hari4579/temp_BMS/README.md

# Distributed Battery Temperature Monitoring System

A modular, CAN-based temperature monitoring system developed for a **7.2 kWh, 40S12P battery pack**. The system uses distributed STM32-based temperature acquisition boards to monitor multiple locations across the battery pack and communicate temperature data to a central Battery Management System (BMS).

The architecture supports **75 NTC temperature-sensing channels**, combining five distributed monitoring boards with 13 channels each and 10 additional temperature-sensing points.

---

## 1. Project Overview

Battery temperature monitoring is essential for identifying thermal abnormalities and improving battery pack safety. This project implements a distributed temperature acquisition architecture to monitor temperatures across a high-capacity battery pack.

Instead of routing every thermistor signal to a single controller, temperature measurements are acquired locally by distributed microcontroller-based boards. Each board processes its NTC inputs, calculates temperature, performs fault checks, and transmits the acquired data over a CAN network.

### System Specifications

| Parameter | Specification |
|---|---|
| Battery pack energy | 7.2 kWh |
| Battery configuration | 40S12P |
| Total cell positions | 480 |
| Temperature-monitoring boards | 5 |
| NTC channels per board | 13 |
| Channels across five boards | 65 |
| Additional NTC sensors | 10 |
| **Total temperature-sensing channels** | **75** |
| Communication protocol | CAN |
| CAN bit rate | 500 kbps |
| Microcontroller | STM32F407VET6 |
| Temperature sensor | 10 kΩ NTC |

The 75 sensing points provide distributed temperature monitoring across the battery pack. The system does not assume one thermistor per cell.

## 2. System Architecture

The system follows a distributed temperature acquisition architecture.

Each temperature-monitoring board independently:
1. Acquires 13 NTC thermistor signals.
2. Converts ADC readings into thermistor resistance.
3. Calculates temperature using the Beta equation.
4. Checks for overtemperature and sensor faults.
5. Transmits temperature telemetry through CAN.

The distributed boards communicate with the central BMS controller over a shared CAN network.

### Architecture Diagram

```text
              7.2 kWh Battery Pack
                    40S12P
                       |
           Distributed NTC Sensors
                       |
       +---------------+---------------+
       |               |               |
       v               v               v
 +-----------+   +-----------+   +-----------+
 | Board 1   |   | Board 2   |   | Board 3   |
 | STM32     |   | STM32     |   | STM32     |
 | 13 NTC    |   | 13 NTC    |   | 13 NTC    |
 +-----------+   +-----------+   +-----------+
       |               |               |
       +---------------+---------------+
                       |
                 CAN Bus
                 500 kbps
                       |
       +---------------+---------------+
       |                               |
       v                               v
 +-----------+                   +-----------+
 | Board 4   |                   | Board 5   |
 | STM32     |                   | STM32     |
 | 13 NTC    |                   | 13 NTC    |
 +-----------+                   +-----------+
       |                               |
       +---------------+---------------+
                       |
                 CAN Network
                       |
                       v
             +------------------+
             | BMS Master       |
             | APARD32690       |
             +------------------+
                       |
                       v
              Battery Monitoring

       Additional temperature sensing:
                  10 NTC points

       Total system capacity: 75 channels
```

## 3. Hardware Design

### 3.1 Microcontroller – STM32F407VET6

Each temperature-monitoring board uses the STM32F407VET6 microcontroller.

Key features:
- ARM Cortex-M4 processor.
- 32-bit processing architecture.
- 12-bit ADC.
- Multiple communication peripherals.
- DMA support for ADC acquisition.
- SWD interface for programming and debugging.

The microcontroller handles thermistor acquisition, temperature conversion, fault detection, and CAN communication.

### 3.2 Temperature Sensing Circuit

The system uses MF55-series 10 kΩ NTC thermistors.

Each thermistor is connected through a voltage-divider circuit using a 10 kΩ reference resistor.

| Parameter | Value |
|---|---|
| Thermistor type | NTC |
| Thermistor resistance at 25°C | 10 kΩ |
| Reference resistor | 10 kΩ |
| Reference voltage | 3.3 V |
| ADC resolution | 12-bit |
| ADC channels per board | 13 |
| Number of boards | 5 |
| Additional sensors | 10 |
| Total sensing channels | 75 |

The analog voltage generated by each voltage divider is sampled by the STM32 ADC.

### 3.3 Temperature Calculation

The firmware converts ADC readings into resistance values and calculates temperature using the Beta equation.

\[
T=\left(\frac{1}{T_0}+\frac{1}{B}\ln\left(\frac{R}{R_0}\right)\right)^{-1}
\]

Where:

- \(T\) = Temperature in Kelvin.
- \(T_0\) = Reference temperature (298.15 K).
- \(B\) = Thermistor Beta coefficient (3950).
- \(R\) = Calculated thermistor resistance.
- \(R_0\) = Thermistor resistance at reference temperature (10 kΩ).

The calculated temperature is converted into Celsius for telemetry transmission.

### 3.4 Power Supply

The board receives a 5 V supply and uses a TLV75733 low-dropout regulator to generate the 3.3 V supply required by the microcontroller and associated circuitry.

### 3.5 CAN Communication

The TJA1051 CAN transceiver provides the physical interface between the STM32 and the CAN bus.

| Parameter | Configuration |
|---|---|
| CAN transceiver | TJA1051 |
| Communication protocol | CAN |
| Bit rate | 500 kbps |
| MCU logic supply | 3.3 V |
| Transceiver supply | 5 V |
| Termination | 120 Ω provision |

The distributed boards transmit temperature measurements to the central BMS controller through the shared CAN network.

---

## 4. PCB Design

The project includes two PCB revisions developed during the hardware design process.

### 4.1 V1 – Proof of Concept



The first PCB revision was developed to establish the hardware architecture and evaluate the initial circuit implementation.

Key design elements:
- STM32F407VET6-based temperature acquisition circuit.
- NTC voltage-divider interfaces.
- 5 V to 3.3 V power regulation.
- CAN transceiver circuitry.
- Test points for hardware measurements and debugging.

### 4.2 V2 – Revised PCB


The second revision represents the subsequent PCB design iteration.

It retains the distributed temperature acquisition architecture and incorporates updates made after the initial proof of concept.

The design integrates:
- STM32F407VET6 microcontroller.
- NTC sensing interfaces.
- Power regulation circuitry.
- CAN communication interface.
- Programming and debugging access.

### 4.3 Four-Layer PCB Stack-Up

The PCB uses a four-layer stack-up to organize signal routing, grounding, and power distribution.

| Layer | Function |
|---|---|
| L1 – Top | Component placement and signal routing |
| L2 – Inner 1 | Ground plane |
| L3 – Inner 2 | Power distribution |
| L4 – Bottom | Signal routing |

The dedicated ground and power layers provide reference planes and help organize routing for the mixed-signal design.

### 4.4 PCB Design Considerations

- Separation of analog temperature-sensing signals and digital circuitry.
- Ground-plane continuity and return-current paths.
- Power distribution for the MCU and CAN transceiver.
- SWD programming and debugging access.
- CAN bus routing and termination provisions.
- Test points for hardware bring-up and debugging.

---

## 5. Firmware Architecture

The firmware is developed using the STM32 Hardware Abstraction Layer (HAL).

The main firmware functions include:

1. ADC initialization and configuration.
2. DMA-based acquisition of 13 NTC channels.
3. ADC data buffering.
4. Conversion of ADC readings into thermistor resistance.
5. Temperature calculation using the Beta equation.
6. Overtemperature and sensor fault detection.
7. CAN telemetry generation and transmission.

### 5.1 ADC Acquisition

The STM32 ADC is configured for 13-channel scanning with DMA.

DMA transfers acquired ADC samples into a memory buffer, reducing the need for continuous CPU polling.

The firmware uses separate buffers to maintain and process acquired temperature data.

### 5.2 Fault Detection

The firmware includes checks for:

- Overtemperature conditions.
- NTC short-circuit conditions.
- NTC open-circuit conditions.

Overtemperature detection uses separate trip and clear thresholds, along with debounce logic, to avoid unnecessary fault triggering due to small measurement fluctuations.

The firmware defines fault codes for reporting the detected condition.

### 5.3 Temperature Telemetry

The firmware packs temperature readings into CAN frames.

Each temperature value is represented as a signed 16-bit fixed-point value, with a scaling factor of 100.

For example:

```text
Temperature:       25.50 °C
Transmitted value: 2550
```

The 13 channels are organized into four CAN frames:

| Frame | Temperature Channels | Payload |
|---|---|---|
| Frame 0 | CH0–CH3 | 8 bytes |
| Frame 1 | CH4–CH7 | 8 bytes |
| Frame 2 | CH8–CH11 | 8 bytes |
| Frame 3 | CH12 | 2 bytes |

The CAN identifier is generated using the board ID and frame index:

\[
CAN\ ID = 0x100 + (BOARD\_ID \times 0x10) + Frame
\]

This allows multiple temperature boards to share the same CAN network while maintaining separate message identifiers.

The firmware schedules telemetry transmission at 100 ms intervals.

### 5.4 CAN Fault Reporting

The firmware also defines fault-reporting messages.

Fault information includes:
- Board identification through the CAN arbitration ID.
- Thermistor channel identification.
- Fault type.

| Fault Code | Description |
|---|---|
| 0 | No fault |
| 1 | Overtemperature |
| 2 | Sensor short |
| 3 | Sensor open |

---

## 6. Repository Structure

```text
Temperature-Monitoring-System/
│
├── PCB/
│   ├── V1/
│   │   └── PCB design files
│   │
│   └── V2/
│       └── PCB design files
│
├── Firmware/
│   ├── Core/
│   │   ├── Inc/
│   │   └── Src/
│   │
│   └── STM32 project files
│
├── Documentation/
│   ├── Design_Report.pdf
│   └── Hardware documentation
│
└── README.md
```

*The directory structure is illustrative and should be adjusted to match the actual repository contents.*

---

## 7. Design Objectives

- Distributed acquisition of battery temperature measurements.
- Monitoring of 75 NTC temperature-sensing points.
- Modular hardware architecture.
- Local digitization of analog temperature signals.
- CAN-based communication with the central BMS.
- Scalable temperature monitoring across multiple battery locations.
- Detection of sensor faults and overtemperature conditions.
- Dedicated PCB design for temperature acquisition and communication.

## 8. Future Development

- Integration of all five temperature boards with the BMS master.
- Integration and documentation of the 10 additional temperature-sensing channels.
- Validation of temperature readings against calibrated reference measurements.
- CAN communication testing under multi-node operation.
- Hardware validation of sensor open-circuit and short-circuit detection.
- Integration of temperature fault information into BMS shutdown logic.
- Evaluation of communication reliability and timing under full system load.

## 9. Project Status

The project includes the temperature-monitoring hardware design, two PCB revisions, and STM32 firmware development.

The firmware implements ADC acquisition, NTC temperature conversion, fault detection logic, and CAN telemetry generation.

Full multi-board integration, additional sensor integration, and system-level validation remain development objectives.

## 10. Testing and Demonstration

A testing video demonstrating the temperature-monitoring system and its hardware operation is included below.

### Hardware Testing

The demonstration video showcases the hardware testing process and temperature-monitoring functionality.

**Testing Video:**

[TEMP_PoC.mp4](https://drive.google.com/file/d/1_f34zJ-By_HTeCJ9r7HJWei0OFtLDCeV/view?usp=drive_link)

The video provides a visual demonstration of the prototype during testing.
## Technologies Used

- **Microcontroller:** STM32F407VET6
- **Embedded Development:** Embedded C, STM32 HAL
- **Temperature Sensing:** 10 kΩ NTC thermistors
- **Analog Acquisition:** 12-bit ADC, DMA
- **Communication:** CAN, TJA1051
- **Power Regulation:** TLV75733
- **PCB Design:** Four-layer PCB
- **BMS Platform:** APARD32690, ADBMS6830
