hari4579/temp_BMS/support_final/production/bom_7s.csv

Designator | Footprint | Quantity | Value | LCSC Part #
C1, C4 | 805 | 2 | 2.2uF X7R 0805
C10, C11 | 603 | 2 | 2.2uF X7R 0603
C12 | 603 | 1 | 1uF X7R 0603
C13, C35, C6, C9 | 402 | 4 | 0.1uF X7R 0402
C14, C15, C16, C18, C8 | 603 | 5 | 0.1uF X7R 0603
C2 | 805 | 1 | 1uF X7R 0805
C21, C5, C7 | 603 | 3 | 4.7uF X7R 0603
C3 | 805 | 1 | 22uF X7R 0805
C34 | 603 | 1 | 10uF X7R 0603
D1 | 603 | 1 | LED 0603 BLUE
D2 | diode | 1 | 1N5819WS
D3 | 603 | 1 | LED 0603
F1, F2, F3, F4, F5, F6, F7 | 0453Series_LTF | 7 | 0453.400MR
R1, R10, R11, R12, R13, R17, R2, R3, R4, R5, R6, R7, R8, R9 | 402 | 14 | 10k 0402
R15, R21 | 402 | 2 | 330 ohms 0402
R16 | 603 | 1 | 120 ohms 0603
SW2 | SW_SPST_TS-1088-xR020 | 1 | SW_Push
U1 | SOIC-8_3.9x4.9mm_P1.27mm | 1 | TJA1051T-3
U2 | LQFP-100_14x14mm_P0.5mm | 1 | STM32F446VETx
U4 | SOT-223-3_TabPin2 | 1 | AMS1117-3.3
