hari4579/temp_BMS/support_final/support_final.step

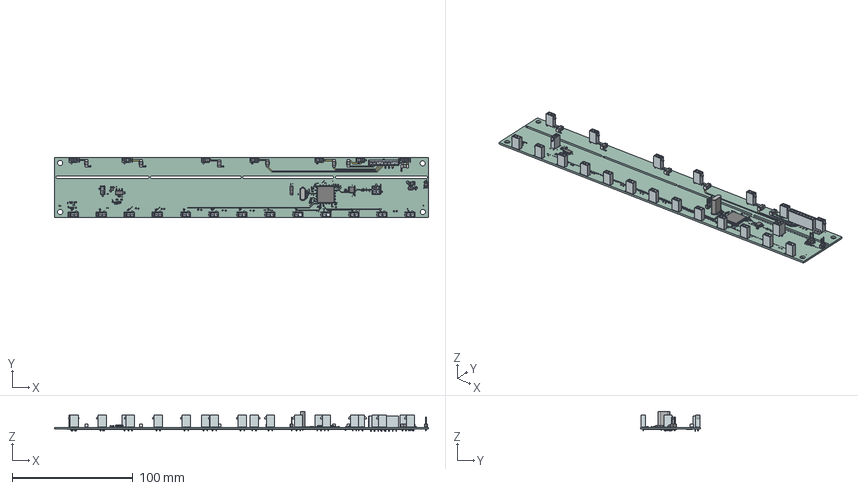
[picture p7: CAD file, 2026-10-30]
support_final/support_final.step
310.0 x 50.0 x 16.7 mm
R_0402_1005Metric x 18
SOIC-8_3.9x4.9mm_P1.27mm
C_0805_2012Metric x 4
C_0603_1608Metric x 12
2165711008wbm000_03
C_0402_1005Metric x 5
LQFP-100_14x14mm_P0.5mm
SOT-223
LED_0603_1608Metric
2068320401wbm000_01
PinHeader_1x02_P254mm_Vertical x 2
Crystal_HC49-U_Vertical
PinHeader_1x03_P254mm_Vertical
SW_SPST_TS-1088-xR020
R_0603_1608Metric
support_final_copper
support_final_via
support_final_silkscreen x 2
support_final_PCB
