hari4579/temp_BMS/support_final/support_final.kicad_pcb

## KiCad design support_final/support_final.kicad_pcb (2026-10-30)

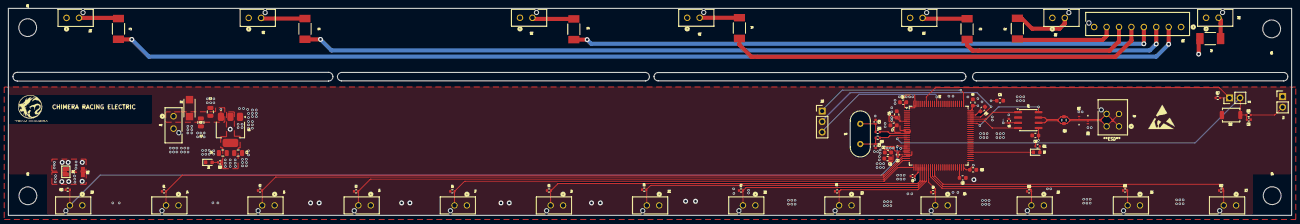
[picture p8: board support_final.kicad_pcb from above]

Board: 4 copper layers, 310.0 x 50.0 mm, 91 parts (1 on the bottom side), 51 nets.

Parts:
C1, C4: 2.2uF X7R 0805; C_0805_2012Metric
C2: 1uF X7R 0805; C_0805_2012Metric
C3: 22uF X7R 0805; C_0805_2012Metric
C5, C7, C21: 4.7uF X7R 0603; C_0603_1608Metric
C6, C9, C13, C35: 0.1uF X7R 0402; C_0402_1005Metric
C8, C14, C15, C16, C18: 0.1uF X7R 0603; C_0603_1608Metric
C10, C11: 2.2uF X7R 0603; C_0603_1608Metric
C12: 1uF X7R 0603; C_0603_1608Metric
C19, C20: 20pF; C_0402_1005Metric
C34: 10uF X7R 0603; C_0603_1608Metric
CR1, CR2: PESD1CANFD36LS-QYL; PESD1
D1: LED 0603 BLUE; LED_0603_1608Metric
D2: 1N5819WS; diode
D3: LED 0603; LED_0603_1608Metric
F1, F2, F3, F4, F5, F6, F7: 0453.400MR; 0453Series_LTF
FB1: 80-120mohm (400mA -600mA) 0603 (BLM18AG121SN1D); BEADC1608X65N
H1, H2, H3, H4: MountingHole; MountingHole_4.3mm_M4
J1, J4, J5, J6, J7, J8, J11, J12, J13, J14, J15, J16, J17, J18, J21, J22, J23, J24, J25, J26, J27: Conn_01x02_Socket; microfit+_2
J2, J3: Conn_01x02_Pin; PinHeader_1x02_P2.54mm_Vertical
J9: Conn_01x04_Pin; CONN_2068320000-SD_04_MOL
J10: Conn_01x03_Socket; PinHeader_1x03_P2.54mm_Vertical
J20: Conn_01x08_Socket; CONN_2165710003-SD_08_MOL
JP1: SolderJumper_2_Open; SolderJumper-2_P1.3mm_Open_Pad1.0x1.5mm
R1, R2, R3, R4, R5, R6, R7, R8, R9, R10, R11, R12, R13, R17, R20: 10k 0402; R_0402_1005Metric
R15, R21: 330 ohms 0402; R_0402_1005Metric
R16: 120 ohms 0603; R_0603_1608Metric
R18: 0 ohms; R_0402_1005Metric
R19: 33 ohms; R_0402_1005Metric
SW2: SW_Push; SW_SPST_TS-1088-xR020
U1: TJA1051T-3; SOIC-8_3.9x4.9mm_P1.27mm
U2: STM32F446VETx; LQFP-100_14x14mm_P0.5mm
U4: AMS1117-3.3; SOT-223-3_TabPin2
Y1: 26MHz(YXC - HC-49US); Crystal_HC49-U_Vertical

Connections:
3.3V: C3.1, C4.1, C7.1, C8.1, C9.1, C14.1, C15.1, C16.1, C18.1, FB1.2, J2.2, JP1.1 (A), R15.1, R20.2, R21.1, U1.5 (VIO), U2.6 (VBAT), U2.11 (VDD), U2.19 (VDD), U2.28 (VDD), U2.50 (VDD), U2.75 (VDD), U2.100 (VDD), U4.2 (VO)
/MCU/BOOT0: J3.1, R17.2, U2.94 (BOOT0)
/MCU/RST: C35.1, J3.2, R20.1, SW2.2, U2.14 (NRST)
/MCU/SWCLK: J10.1, U2.76 (PA14)
/MCU/SWDIO: J10.2, U2.72 (PA13)
/MCU/SWO: J10.3, U2.89 (PB3)
/NTC/C1: F7.2, J20.2
/NTC/C1_f: F7.1, J27.2
/NTC/C2: F6.2, J20.3
/NTC/C2_f: F6.1, J26.2 (Pin_2_2)
/NTC/C3: F5.2, J20.4
/NTC/C3_f: F5.1, J25.2 (Pin_2_2)
/NTC/C4: F4.2, J20.5
/NTC/C4_f: F4.1, J24.2 (Pin_2_2)
/NTC/C5: F3.2, J20.6
/NTC/C5_f: F3.1, J23.2 (Pin_2_2)
/NTC/C6: F2.2, J20.7
/NTC/C6_f: F2.1, J22.2 (Pin_2_2)
/NTC/C7: F1.2, J20.8
/NTC/C7_f: F1.1, J21.2
/NTC/s_ground: J20.1, J21.1, J27.1
A0: J4.2, R1.2, U2.23 (PA0)
A1: J5.2, R2.2, U2.24 (PA1)
A2: J6.2, R3.2, U2.25 (PA2)
A3: J7.2, R4.2, U2.26 (PA3)
A4: J8.2, R5.2, U2.29 (PA4)
A5: J11.2, R6.2, U2.30 (PA5)
A6: J12.2, R7.2, U2.31 (PA6)
A7: J13.2, R8.2, U2.32 (PA7)
A8: J14.2, R9.2, U2.33 (PC4)
A9: J15.2, R10.2, U2.34 (PC5)
A10: J16.2, R11.2, U2.35 (PB0)
A11: J17.2, R12.2, U2.36 (PB1)
A12: J18.2, R13.2, U2.18 (PC3)
CAN_N: CR2.1, J9.1, J9.2, R16.2, U1.6 (CANL)
CAN_P: CR1.1, J9.3, J9.4, R16.1, U1.7 (CANH)
CAN_S: U1.8 (S), U2.69 (PA10)
CAN_rx: U1.4 (RXD), U2.70 (PA11)
CAN_tx: U1.1 (TXD), U2.71 (PA12)
GND: C1.2, C2.2, C3.2, C4.2, C5.2, C6.2, C7.2, C8.2, C9.2, C10.2, C11.2, C12.2, C13.2, C14.2, C15.2, C16.2, C18.2, C19.1, C20.1, C21.2, C34.2, C35.2, CR1.2, CR2.2, D1.1 (K), D2.2 (A), J1.2, J2.1, R1.1, R2.1, R3.1, R4.1, R5.1, R6.1, R7.1, R8.1, R9.1, R10.1, R11.1, R12.1, R13.1, R17.1, SW2.1, U1.2 (GND), U2.10 (VSS), U2.20 (VSSA), U2.27 (VSS), U2.49 (VSS), U2.74 (VSS), U2.99 (VSS), U4.1 (GND)
unnamed: C19.2, R18.1, Y1.2
unnamed: C20.2, R19.1, Y1.1
unnamed: D1.2 (A), R15.2
unnamed: D3.2 (A), R21.2
unnamed: D3.1 (K), U2.55 (PD8)
unnamed: R18.2, U2.12 (PH0)
unnamed: R19.2, U2.13 (PH1)
unnamed: C10.1, U2.48 (VCAP_1)
unnamed: C11.1, U2.73 (VCAP_2)
Vdda: C12.1, C13.1, C21.1, FB1.1, J4.1, J5.1, J6.1, J7.1, J8.1, J11.1, J12.1, J13.1, J14.1, J15.1, J16.1, J17.1, J18.1, JP1.2 (B), U2.21 (VREF+), U2.22 (VDDA)
Vin: C1.1, C2.1, C5.1, C6.1, C34.1, D2.1 (K), J1.1, U1.3 (VCC), U4.3 (VI)
