hari4579/temp_BMS/Core/Src/main.c

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
/* Includes ------------------------------------------------------------------*/
#include "main.h"

ADC_HandleTypeDef hadc1;
DMA_HandleTypeDef hdma_adc1;

CAN_HandleTypeDef hcan1;

/* USER CODE BEGIN PV */
#define NTC_CHANNELS   13     // physical channel count per board
#define BOARD_ID       0      // 0-5, UNIQUE per board, sets CAN ID offset

/* NTC divider + ADC physical constants (R1=NTC->3.3V, R2=10k->GND) */
#define R25         10000.0f  // NTC resistance at 25C
#define BETA        3950.0f   // NTC beta coefficient
#define T25_K       298.15f   // 25C in Kelvin
#define R_FIXED     10000.0f  // fixed reference resistor (R2)
#define VREF        3.3f      // ADC reference voltage
#define ADC_MAX     4095.0f   // 12-bit ADC full scale

/*Global variables */
volatile uint16_t adc_vals[NTC_CHANNELS];
volatile int16_t temp_buffer_A[NTC_CHANNELS];   // ISR writes here (raw ADC counts)
volatile int16_t temp_buffer_B[NTC_CHANNELS];   // main loop's private snapshot



volatile uint16_t OT_TRIP_RAW       = 3155;  // over-temp trip threshold (raw ADC count)
volatile uint16_t OT_CLEAR_RAW      = 2854;  // over-temp hysteresis clear threshold
volatile uint16_t SENSOR_SHORT_RAW  = 50;    // near-0V -> open NTC / broken wire
volatile uint16_t SENSOR_OPEN_RAW   = 4045;  // near-3.3V -> shorted NTC / broken ref resistor

volatile uint8_t OT_DEBOUNCE_N     = 5;
volatile uint8_t SENSOR_DEBOUNCE_N = 1;

typedef enum {
    FAULT_NONE = 0,
    FAULT_OVERTEMP,
    FAULT_SENSOR_SHORT,   // reads near 0V
    FAULT_SENSOR_OPEN,    // reads near 3.3V
} fault_type_t;

volatile fault_type_t fault_latched_type[NTC_CHANNELS];  // latched fault, if any, per channel
volatile uint8_t      fault_debounce_count[NTC_CHANNELS]; // consecutive-sample counter, shared

#define FAULT_GPIO_Port   GPIOB
#define FAULT_GPIO_Pin    GPIO_PIN_0

/* USER CODE END PV */

void SystemClock_Config(void);
static void MX_GPIO_Init(void);
static void MX_DMA_Init(void);
static void MX_ADC1_Init(void);
static void MX_CAN1_Init(void);
/* USER CODE BEGIN 0 */

HAL_StatusTypeDef CAN_SendFault(uint8_t channel, fault_type_t type);

void HAL_ADC_ConvCpltCallback(ADC_HandleTypeDef *hadc)
{
    if (hadc->Instance != ADC1) return;

    for (uint8_t ch = 0; ch < NTC_CHANNELS; ch++)
    {
        uint16_t raw = adc_vals[ch];

        if (raw <= SENSOR_SHORT_RAW)
        {
            if (fault_debounce_count[ch] < SENSOR_DEBOUNCE_N)
                fault_debounce_count[ch]++;

            if (fault_debounce_count[ch] >= SENSOR_DEBOUNCE_N &&
                fault_latched_type[ch] == FAULT_NONE)
            {
                fault_latched_type[ch] = FAULT_SENSOR_SHORT;
                CAN_SendFault(ch, FAULT_SENSOR_SHORT);
            }
        }
        else if (raw >= SENSOR_OPEN_RAW)
        {
            if (fault_debounce_count[ch] < SENSOR_DEBOUNCE_N)
                fault_debounce_count[ch]++;

            if (fault_debounce_count[ch] >= SENSOR_DEBOUNCE_N &&
                fault_latched_type[ch] == FAULT_NONE)
            {
                fault_latched_type[ch] = FAULT_SENSOR_OPEN;
                CAN_SendFault(ch, FAULT_SENSOR_OPEN);
            }
        }
        else if (raw >= OT_TRIP_RAW)
        {
            if (fault_debounce_count[ch] < OT_DEBOUNCE_N)
                fault_debounce_count[ch]++;

            if (fault_debounce_count[ch] >= OT_DEBOUNCE_N &&
                fault_latched_type[ch] == FAULT_NONE)
            {
                fault_latched_type[ch] = FAULT_OVERTEMP;
                CAN_SendFault(ch, FAULT_OVERTEMP);
            }
        }
        else if (raw <= OT_CLEAR_RAW)
        {
            fault_debounce_count[ch] = 0;
        }

        temp_buffer_A[ch] = (int16_t)raw;
    }
}


HAL_StatusTypeDef CAN_SendFault(uint8_t channel, fault_type_t type)
{
    CAN_TxHeaderTypeDef tx_header;
    uint8_t tx_data[8] = {0};
    uint32_t tx_mailbox;

    tx_header.StdId = BOARD_ID;              // 0x000-0x005: dominant arbitration
    tx_header.IDE = CAN_ID_STD;
    tx_header.RTR = CAN_RTR_DATA;
    tx_header.DLC = 8;
    tx_header.TransmitGlobalTime = DISABLE;

    tx_data[0] = channel;                    // which of 13 channels faulted
    tx_data[1] = (uint8_t)type;               // fault type enum value

    if (HAL_CAN_GetTxMailboxesFreeLevel(&hcan1) == 0)
    {
        /* Mailbox full: correctness requirement is to NOT block here.
           TODO: implement retry-pending flag + retry on next cycle,
           rather than silently dropping (flagged as still open). */
        return HAL_ERROR;
    }

    return HAL_CAN_AddTxMessage(&hcan1, &tx_header, tx_data, &tx_mailbox);
}

void Fault_Reset(uint8_t channel)
{
    fault_latched_type[channel] = FAULT_NONE;
    fault_debounce_count[channel] = 0;
    /* No GPIO to manage - master decides all downstream action based on CAN fault frames */
}

static float ADC_ToTemperature(uint16_t adc_count)
{
    float v_out, r_ntc, temp_k;

    /* Guard against divide-by-zero / log(0) at the extremes */
    if (adc_count == 0) adc_count = 1;
    if (adc_count >= (uint16_t)ADC_MAX) adc_count = (uint16_t)ADC_MAX - 1;

    v_out = (adc_count * VREF) / ADC_MAX;

    /* R1 (NTC) -> 3.3V, R2 (fixed) -> GND, ADC reads the divider node:
       Vout = VREF * R2 / (R_ntc + R2)
       Rearranged for R_ntc: R_ntc = R2 * (VREF - Vout) / Vout */
    r_ntc = R_FIXED * (VREF - v_out) / v_out;

    /* Beta equation (simplified Steinhart-Hart) */
    temp_k = 1.0f / ((1.0f / T25_K) + (1.0f / BETA) * logf(r_ntc / R25));

    return temp_k - 273.15f;
}

static int16_t Temp_ToFixedPoint(float temp_c)
{
    float scaled = temp_c * 100.0f;

    if (scaled >= 0.0f)
        return (int16_t)(scaled + 0.5f);
    else
        return (int16_t)(scaled - 0.5f);
}

void Send_Telemetry_Frames(int16_t *raw_snapshot)
{
    CAN_TxHeaderTypeDef tx_header;
    uint8_t tx_data[8];
    uint32_t tx_mailbox;
    int16_t temp_fixed[NTC_CHANNELS];

    /* Convert all 13 raw ADC snapshots to fixed-point degC x100 */
    for (uint8_t i = 0; i < NTC_CHANNELS; i++)
    {
        float temp_c = ADC_ToTemperature((uint16_t)raw_snapshot[i]);
        temp_fixed[i] = Temp_ToFixedPoint(temp_c);
    }

    tx_header.IDE = CAN_ID_STD;
    tx_header.RTR = CAN_RTR_DATA;
    tx_header.TransmitGlobalTime = DISABLE;

    /* Frames 0-2: 4 channels each, big-endian int16 packing */
    for (uint8_t frame = 0; frame < 3; frame++)
    {
        for (uint8_t i = 0; i < 4; i++)
        {
            int16_t val = temp_fixed[frame * 4 + i];
            tx_data[2*i]     = (uint8_t)((val >> 8) & 0xFF);
            tx_data[2*i + 1] = (uint8_t)(val & 0xFF);
        }

        tx_header.StdId = 0x100 + (BOARD_ID * 0x10) + frame;
        tx_header.DLC = 8;

        if (HAL_CAN_GetTxMailboxesFreeLevel(&hcan1) > 0)
            HAL_CAN_AddTxMessage(&hcan1, &tx_header, tx_data, &tx_mailbox);
    }

    /* Frame 3: last channel only */
    {
        int16_t val = temp_fixed[12];
        tx_data[0] = (uint8_t)((val >> 8) & 0xFF);
        tx_data[1] = (uint8_t)(val & 0xFF);

        tx_header.StdId = 0x100 + (BOARD_ID * 0x10) + 3;
        tx_header.DLC = 2;

        if (HAL_CAN_GetTxMailboxesFreeLevel(&hcan1) > 0)
            HAL_CAN_AddTxMessage(&hcan1, &tx_header, tx_data, &tx_mailbox);
    }
}
/* USER CODE END 0 */

/**
  * @brief  The application entry point.
  * @retval int
  */
int main(void)
{

  /* MCU Configuration--------------------------------------------------------*/

  /* Reset of all peripherals, Initializes the Flash interface and the Systick. */
  HAL_Init();

  /* Configure the system clock */
  SystemClock_Config();

  /* Initialize all configured peripherals */
  MX_GPIO_Init();
  MX_DMA_Init();
  MX_ADC1_Init();
  MX_CAN1_Init();
  /* USER CODE BEGIN 2 */

  uint32_t last_tx_time = 0;

  HAL_ADC_Start_DMA(&hadc1, (uint32_t*)adc_vals, NTC_CHANNELS);

  /* USER CODE END 2 */

  /* Infinite loop */
  /* USER CODE BEGIN WHILE */
  while (1)
  {
    /* USER CODE END WHILE */

      if (HAL_GetTick() - last_tx_time >= 100)
      {
          last_tx_time = HAL_GetTick();

          /* Atomic snapshot - shortest possible critical section */
          __disable_irq();
          memcpy((void*)temp_buffer_B, (void*)temp_buffer_A, sizeof(temp_buffer_B));
          __enable_irq();

          /* Convert + pack + transmit telemetry - always, fault or not */
          Send_Telemetry_Frames(temp_buffer_B);
      }

      /* Room for other non-blocking background tasks here later,
         e.g. CAN error/bus-off monitoring, watchdog kick, etc. */

    /* USER CODE BEGIN 3 */
  }
  /* USER CODE END 3 */
}

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
