hari4579/temp_BMS/support_code.ioc

Mcu.UserName=STM32F446VETx
PA0-WKUP.Signal=ADCx_IN0
PA1.Signal=ADCx_IN1
PA10.Signal=GPIO_Output
PA11.Signal=CAN1_RX
PA12.Signal=CAN1_TX
PA13.Signal=SYS_JTMS-SWDIO
PA14.Signal=SYS_JTCK-SWCLK
PA15.Signal=SYS_JTDI
PA2.Signal=ADCx_IN2
PA3.Signal=ADCx_IN3
PA4.Signal=ADCx_IN4
PA5.Signal=ADCx_IN5
PA6.Signal=ADCx_IN6
PA7.Signal=ADCx_IN7
PB0.Signal=ADCx_IN8
PB1.Signal=ADCx_IN9
PB3.Signal=SYS_JTDO-SWO
PC0.Signal=ADCx_IN10
PC4.Signal=ADCx_IN14
PC5.Signal=ADCx_IN15
PD8.Signal=GPIO_Output
