hari4579/temp_BMS/(commit log)

2026-10-30 Add README for BMS Temperature Monitoring Module
    Add detailed documentation for BMS Temperature Monitoring Module, including system architecture, features, temperature measurement, fault detection, and CAN communication.
2026-10-30 Revise README for Distributed Battery Monitoring System
    Updated project name and expanded overview with detailed specifications and architecture for the Distributed Battery Temperature Monitoring System.
2026-10-30 Add testing and demonstration section to README
    Added section for testing and demonstration of the temperature-monitoring system, including a link to the testing video.
